JhoanLeon/Proyecto-MAFE/circuitos/sensores 1.jpg

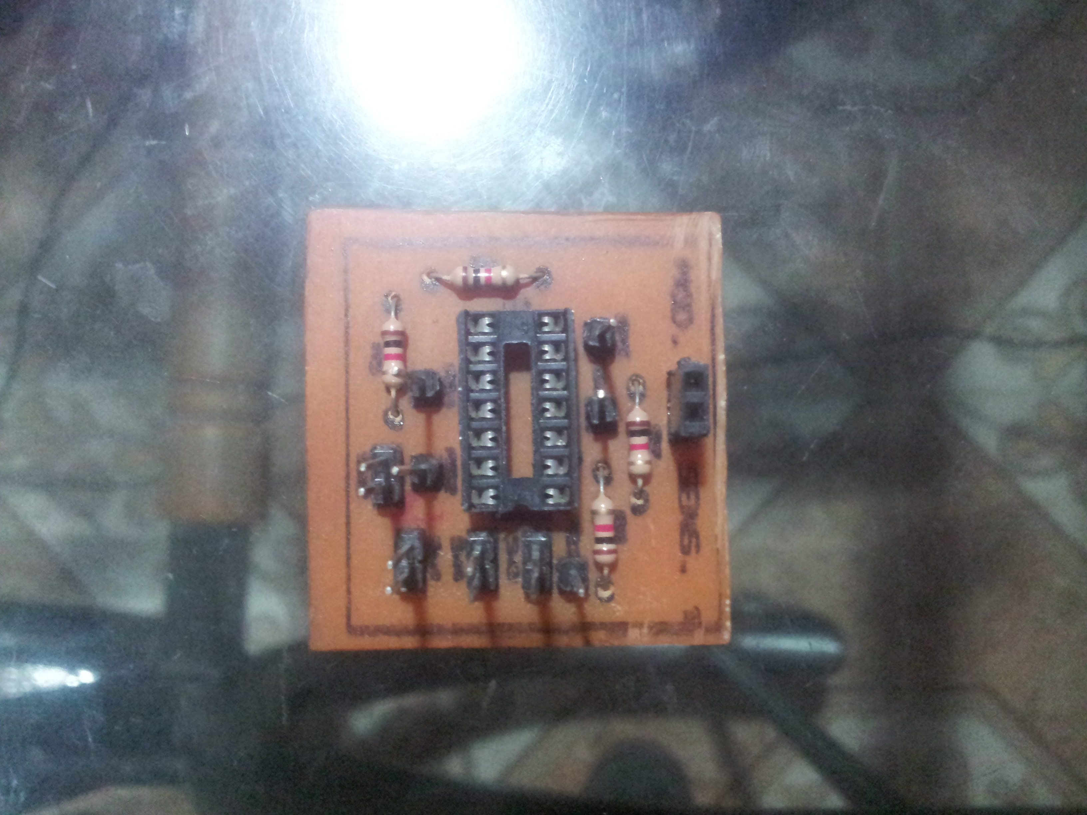
circuitos/sensores 1.jpg
