JhoanLeon/Proyecto-MAFE/anexos/22879273_1474528549298804_1385105198_o.jpg

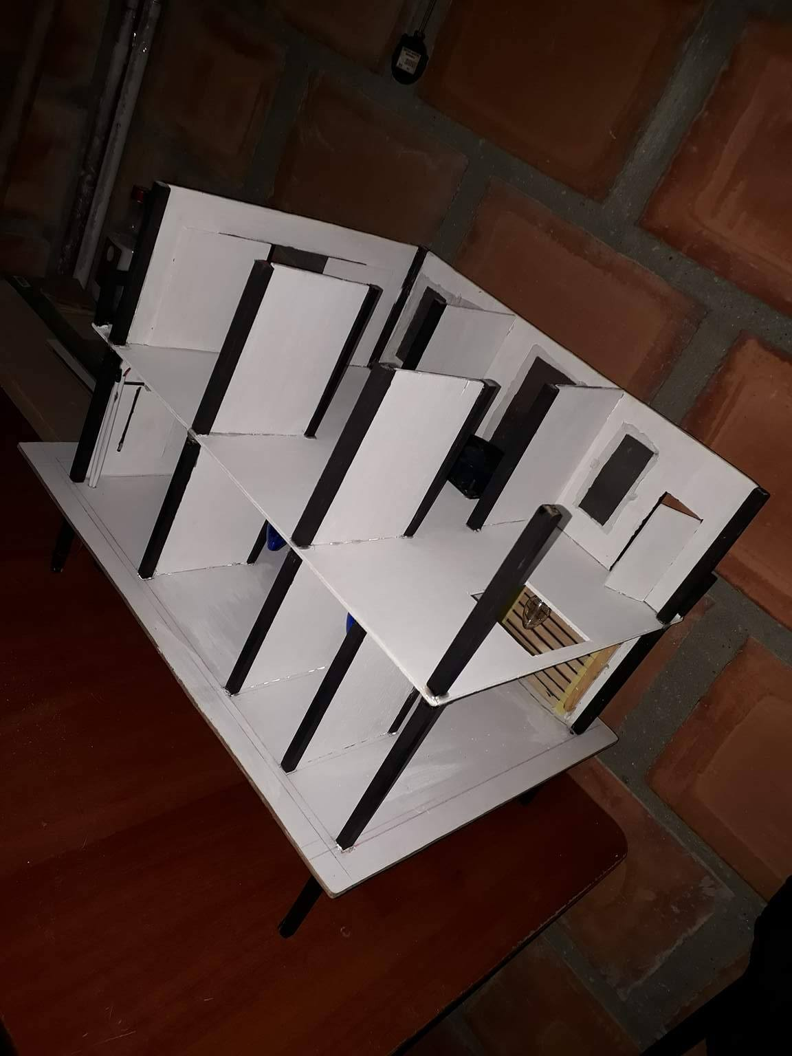
anexos/22879273_1474528549298804_1385105198_o.jpg
