JhoanLeon/Proyecto-MAFE/README.md

# Proyecto-MAFE
Proyecto de Automatización para casas convencionales basado en microcontroladores PIC y en comunicación inalámbrica bluetooth. Realizado en 2017 para obtener el título de bachiller técnico en electricidad y electrónica.

Diseño de esquemáticos y PCBs en el software PROTEUS 8 PROFESSIONAL. Programación de los microcontroladores PIC16F877A en lenguaje C utilizando el software PIC C COMPILER y el programador PICkit2.

Adicionalmente se presenta la documentación realizada del proyecto en la carpeta "Trabajo escrito".

Aquí se presenta una foto del sistema electrónico final, con los 5 módulos diseñados (main, potencia, sensores, motores y comunicación) junto a la fuente de alimentación.

22197838_1452732644811728_685561005_o

Y finalmente el montaje del sistema en la maqueta de presentación.

22882320_1474528212632171_1293554200_o
