JhoanLeon/Proyecto-MAFE/Trabajo escrito MAFE/Varios/Mentefacto proyecto.docx

Se encarga de controlar la parte mecánica del sistema

Se encarga de recibir y ejecutar todas las instrucciones del usuario

Conjunto de sistemas capaces de automatizar una vivienda, ofreciendo servicios de seguridad, gestión energética, bienestar y comunicaciones.

Controla todas las cargas de 120 VAC del proyecto

Módulo de potencia

Módulo de motores

Módulo de comunicación

Alimenta el módulo Bluetooth, la LCD, la sirena y las luces externas

Módulo de control

Módulo de sensores

Alimenta los interruptores magnéticos y la compuerta lógica AND

Modelo de automatización para casas convencionales, con un sistema compuesto por diferentes módulos electrónicos.

Sistema de control para una puerta convencional con fines de seguridad y comodidad

Puerta automática

Proyecto MAFE

Domótica

Compuesto por
