JhoanLeon/Proyecto-MAFE/Trabajo escrito MAFE/Varios/Mentefacto.docx

Electrónica

Digital

Analógica

Electricidad

Física

MAFE

Rama de la electrónica que trabaja con sistemas digitales y señales binarias que sólo toman valores de 1 o 0

Rama de la electrónica que trabaja con circuitos análogos y señales que pueden tomar valores infinitos

Grupo de fenómenos físicos conexos con el flujo y movimiento de electrones

Disciplina que aplica los fenómenos eléctricos originados por la conducción y el flujo de electrones en sistemas electrónicos.

Se clasifica en

Ciencia natural que se encarga del estudio de la energía, la materia, el tiempo y el espacio.
