JhoanLeon/Proyecto-MAFE/anexos/20170814_204834.jpg

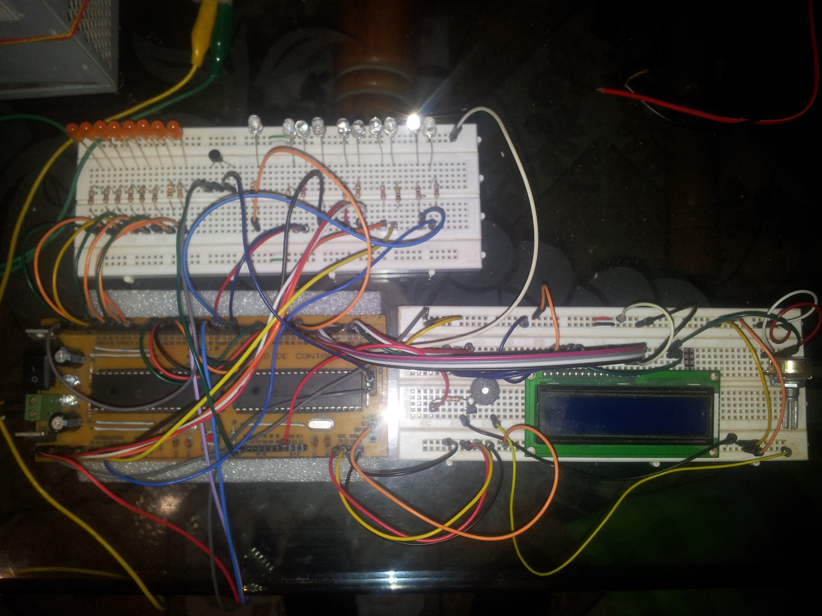
anexos/20170814_204834.jpg
