JhoanLeon/Proyecto-MAFE/anexos/20170814_223258.jpg

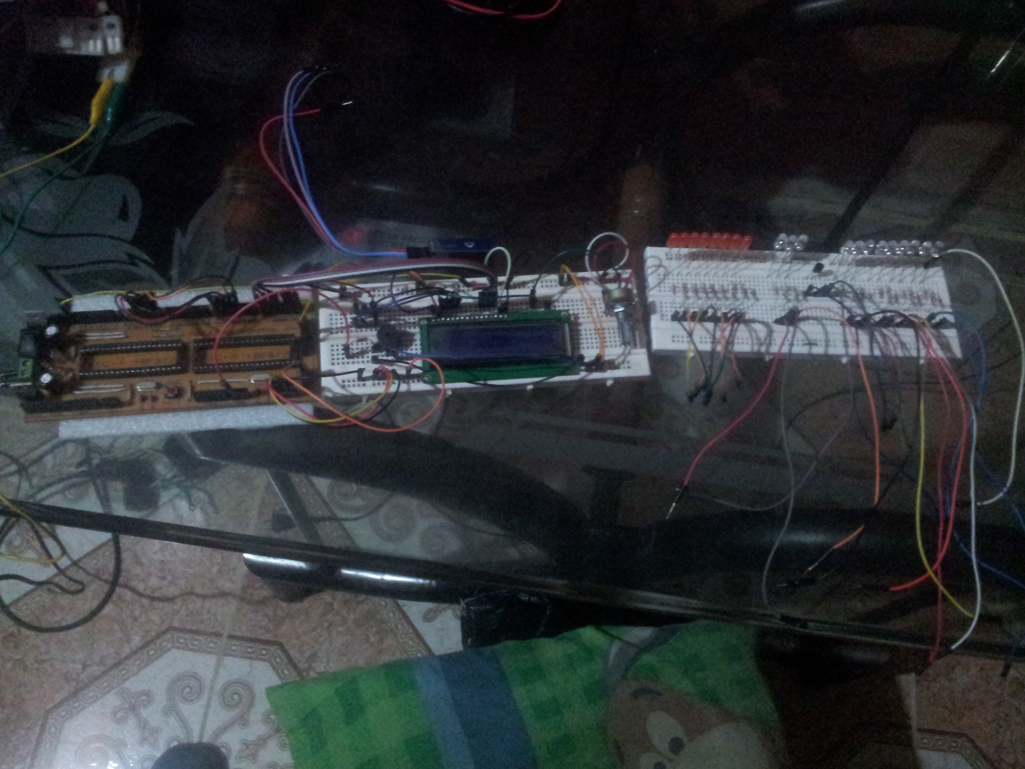
anexos/20170814_223258.jpg
