JhoanLeon/Proyecto-MAFE/anexos/20170830_212114-1.jpg

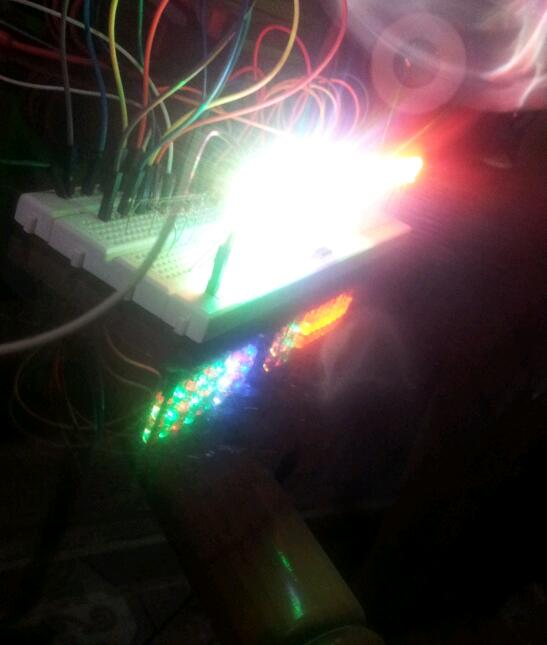
anexos/20170830_212114-1.jpg
