JhoanLeon/Proyecto-MAFE/anexos/20170902_212027.jpg

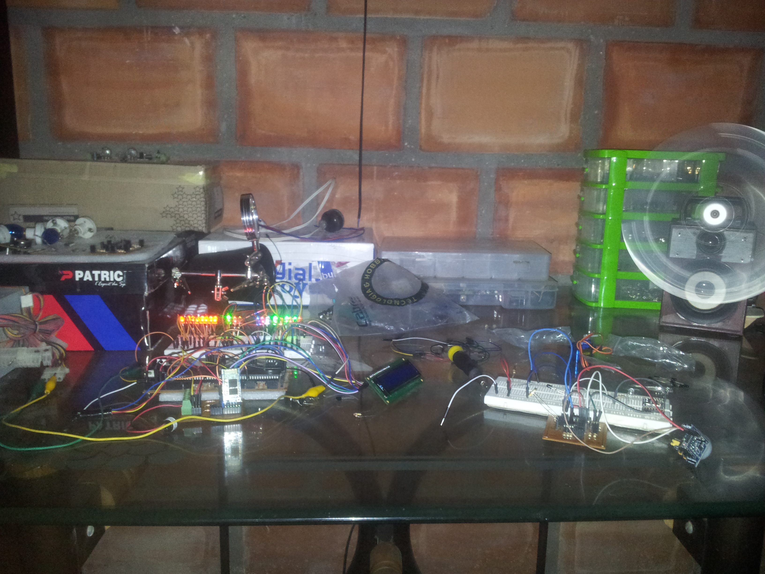
anexos/20170902_212027.jpg
