JhoanLeon/Proyecto-MAFE/anexos/20170904_183217.jpg

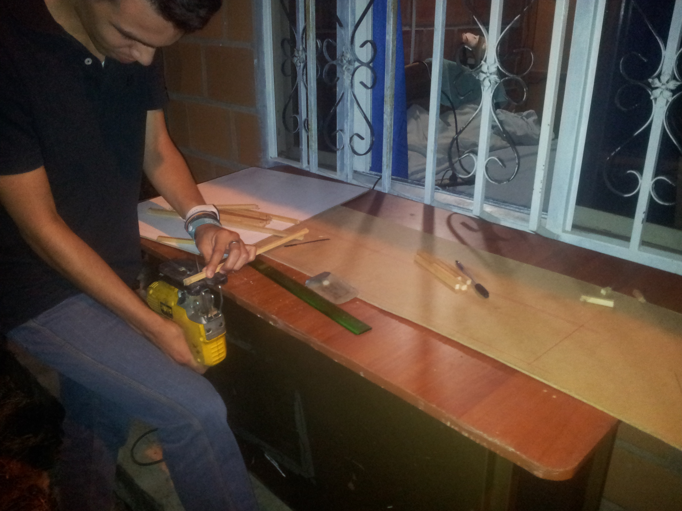
anexos/20170904_183217.jpg
