JhoanLeon/Proyecto-MAFE/anexos/20170904_184807-1.jpg

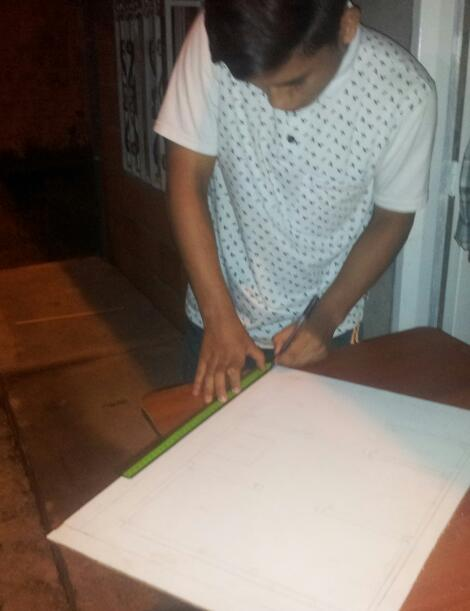
anexos/20170904_184807-1.jpg
