JhoanLeon/Proyecto-MAFE/anexos/20170905_202919.jpg

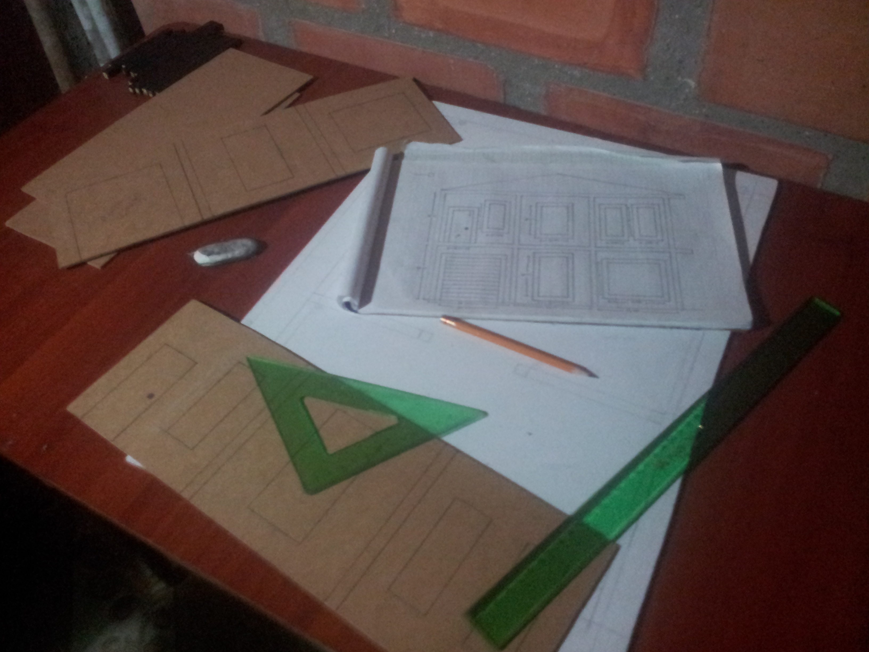
anexos/20170905_202919.jpg
