JhoanLeon/Proyecto-MAFE/anexos/20170905_223407.jpg

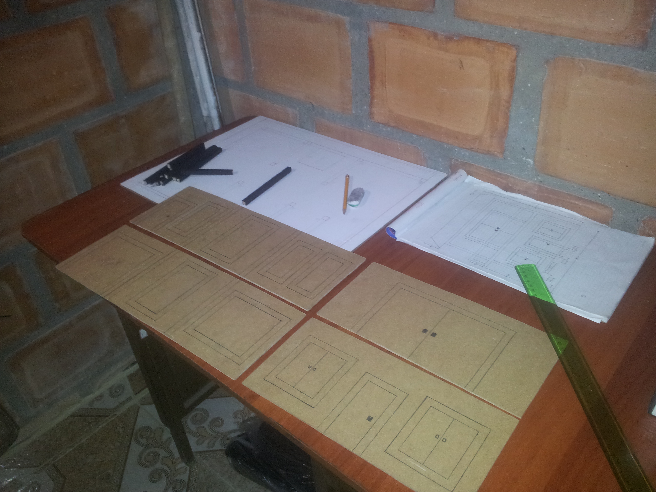
anexos/20170905_223407.jpg
