JhoanLeon/Proyecto-MAFE/anexos/20170907_213115.jpg

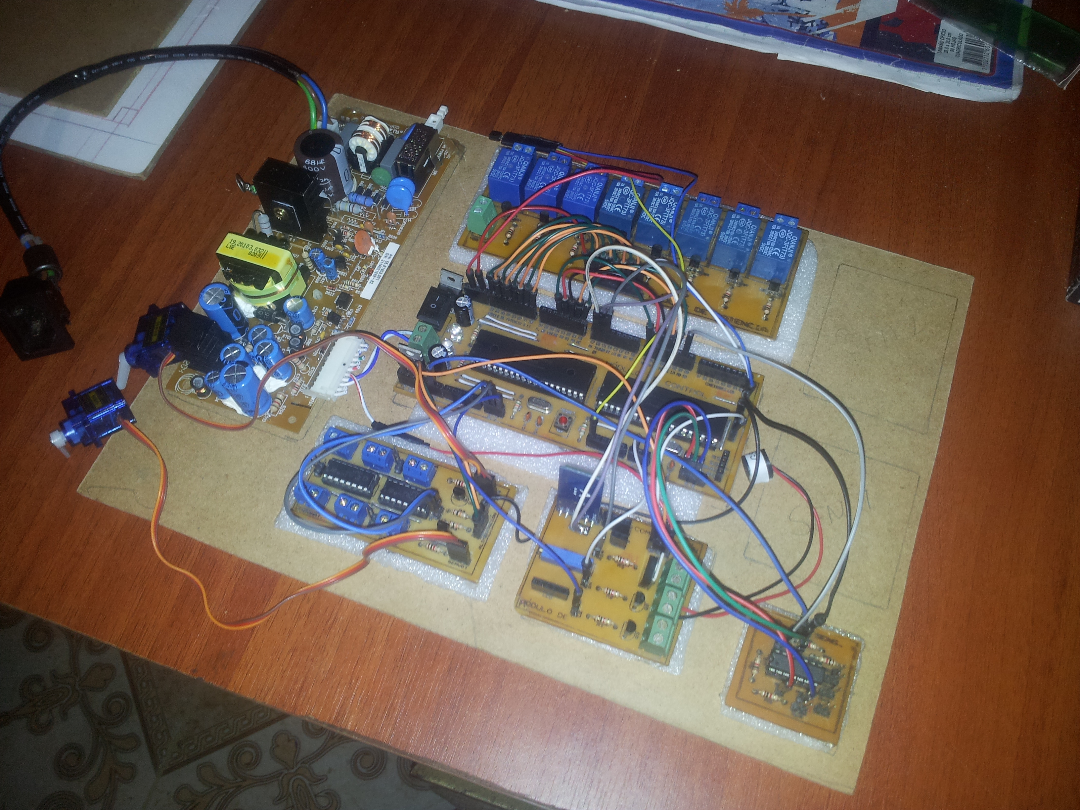
anexos/20170907_213115.jpg
