JhoanLeon/Proyecto-MAFE/anexos/20170911_104920.jpg

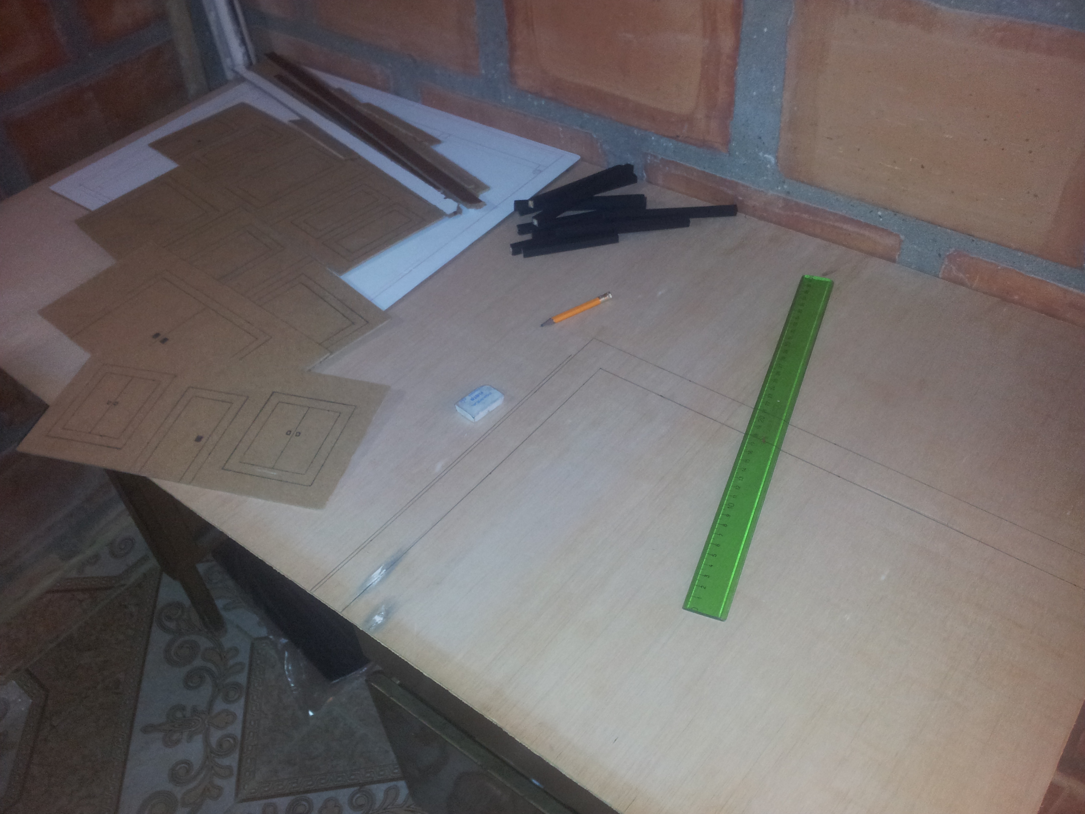
anexos/20170911_104920.jpg
