JhoanLeon/Proyecto-MAFE/anexos/20170913_202242.jpg

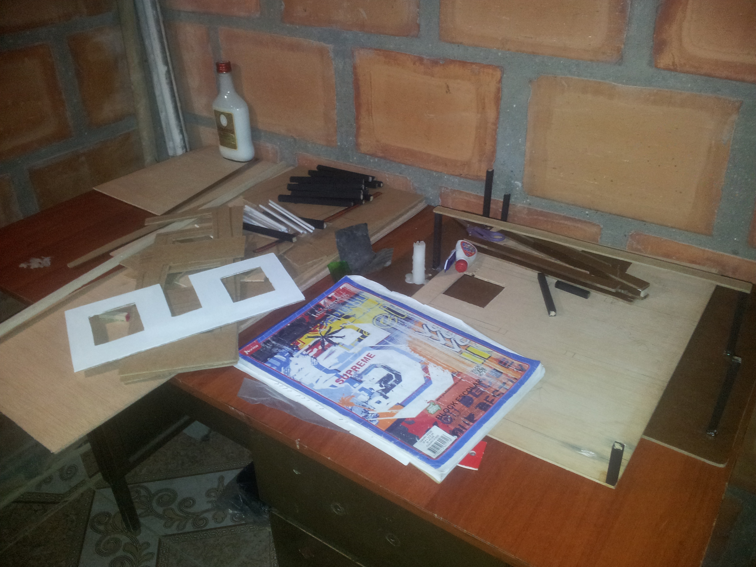
anexos/20170913_202242.jpg
