JhoanLeon/Proyecto-MAFE/anexos/20170914_204048.jpg

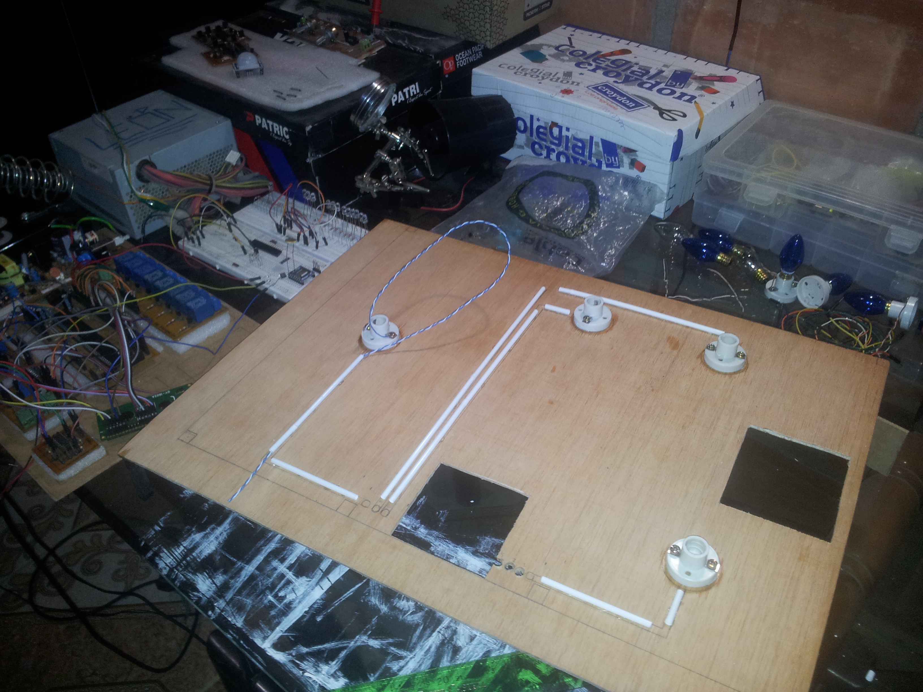
anexos/20170914_204048.jpg
