JhoanLeon/Proyecto-MAFE/anexos/20170914_222317.jpg

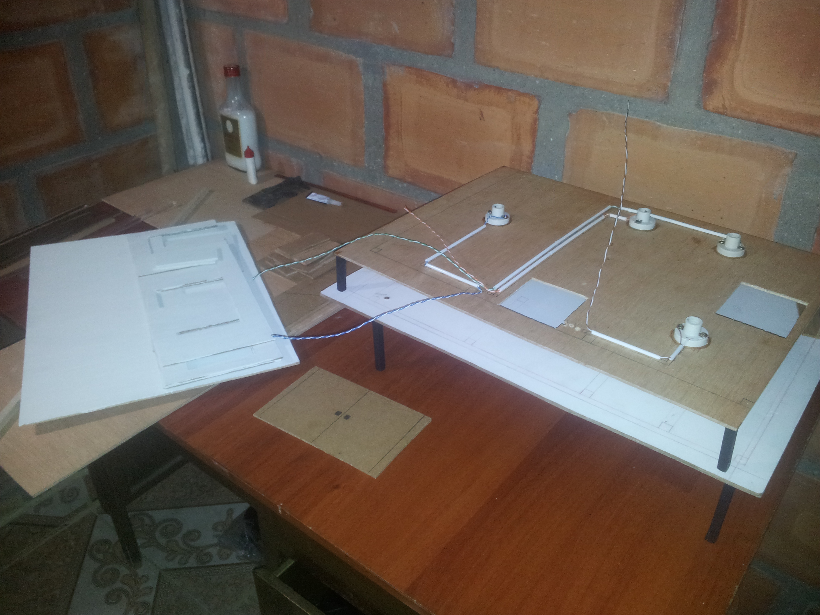
anexos/20170914_222317.jpg
