JhoanLeon/Proyecto-MAFE/circuitos/comunicación.jpg

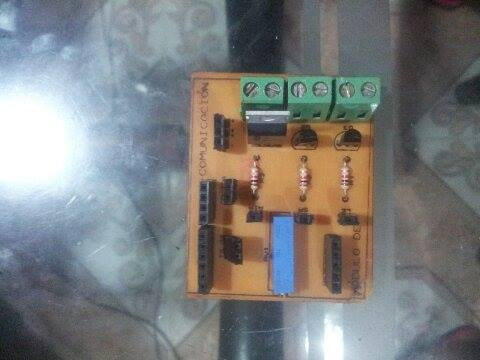
circuitos/comunicación.jpg
