JhoanLeon/Proyecto-MAFE/circuitos/control.jpg

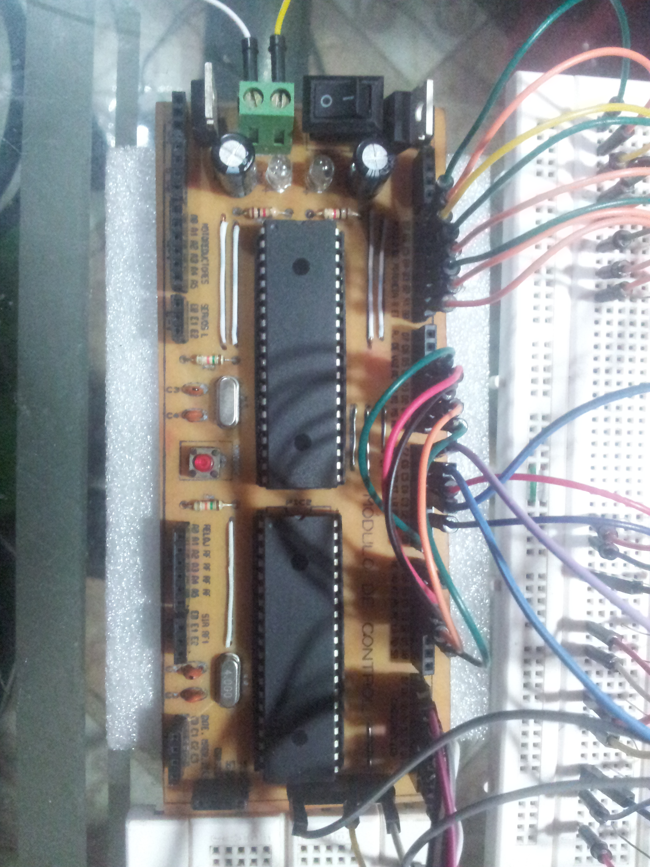
circuitos/control.jpg
