JhoanLeon/Proyecto-MAFE/circuitos/mod comunic isis.png

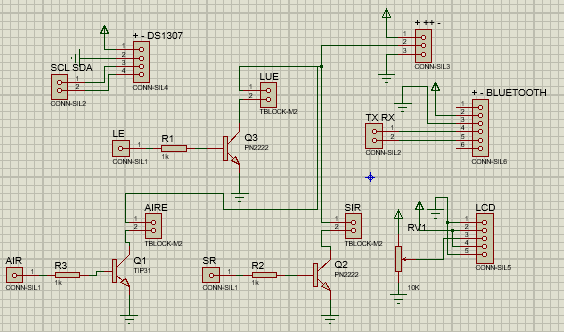
circuitos/mod comunic isis.png
