JhoanLeon/Proyecto-MAFE/circuitos/mod control isis.png

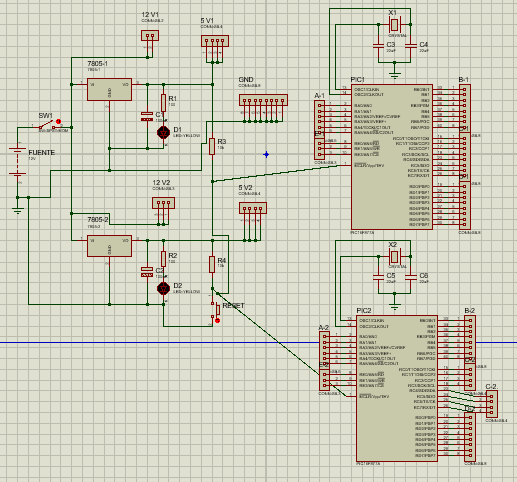
circuitos/mod control isis.png
