JhoanLeon/Proyecto-MAFE/circuitos/mod motor isis.png

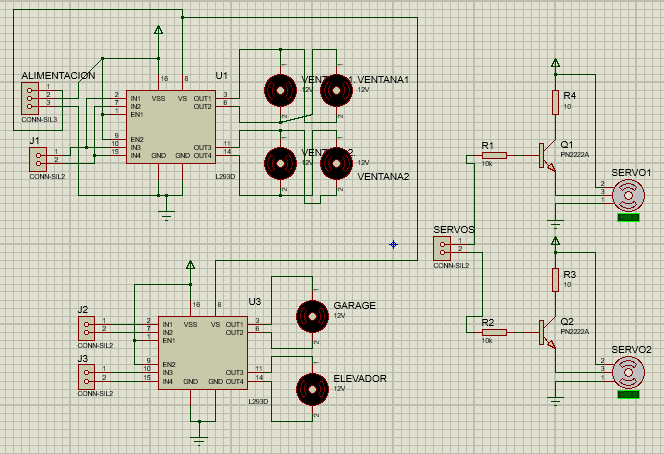
circuitos/mod motor isis.png
