JhoanLeon/Proyecto-MAFE/circuitos/mod poten isis.png

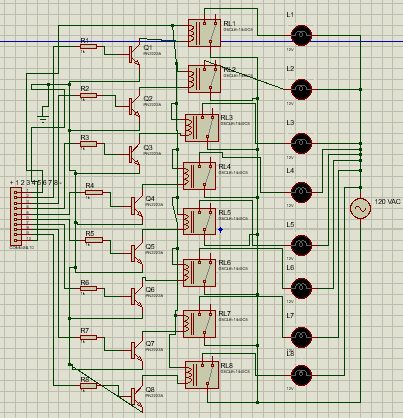
circuitos/mod poten isis.png
