JhoanLeon/Proyecto-MAFE/circuitos/mod sens 0 are.png

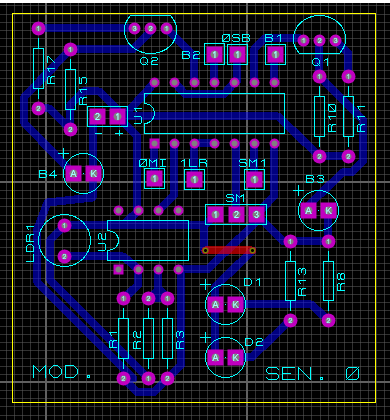
circuitos/mod sens 0 are.png
