JhoanLeon/Proyecto-MAFE/circuitos/mod sens 0 isis.png

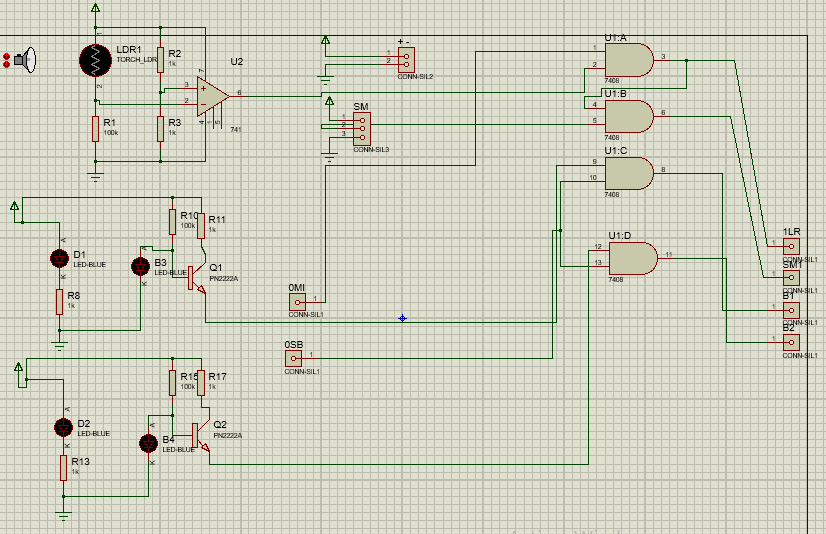
circuitos/mod sens 0 isis.png
