JhoanLeon/Proyecto-MAFE/circuitos/mod sens 1 are.png

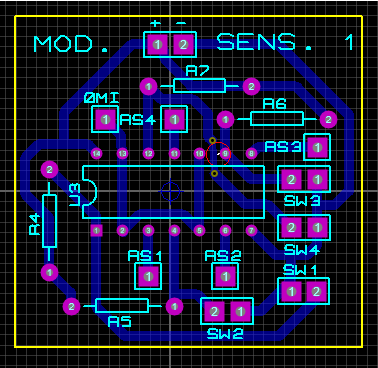
circuitos/mod sens 1 are.png
