JhoanLeon/Proyecto-MAFE/circuitos/mod sens 1 isis.png

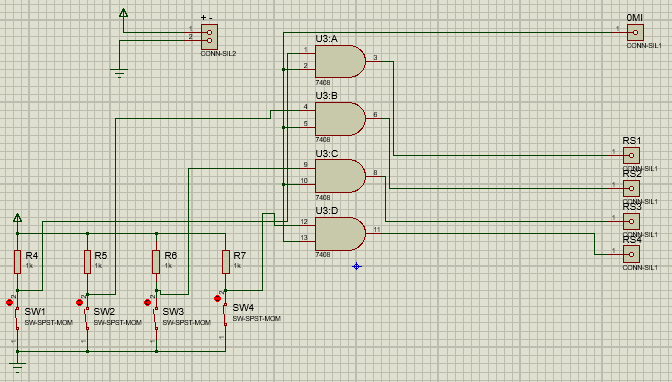
circuitos/mod sens 1 isis.png
