JhoanLeon/Proyecto-MAFE/circuitos/mod sens 2 isis.png

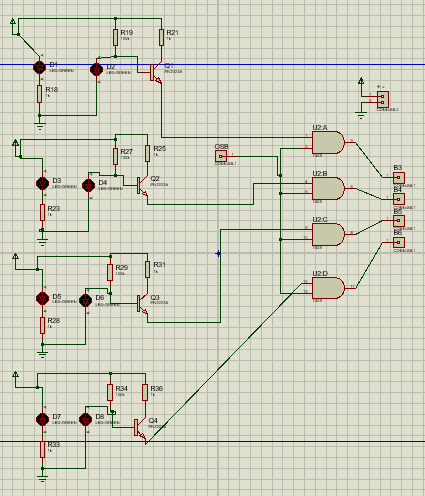
circuitos/mod sens 2 isis.png
