JhoanLeon/Proyecto-MAFE/circuitos/motores.jpg

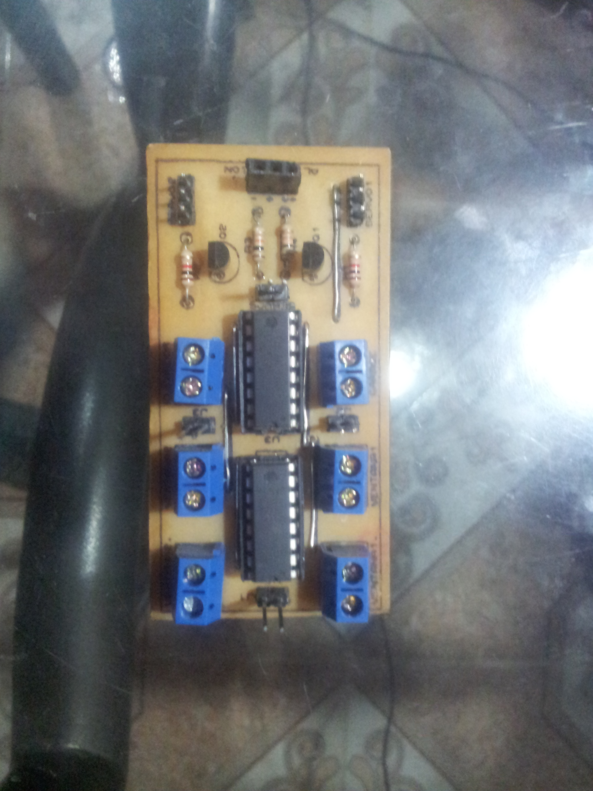
circuitos/motores.jpg
