JhoanLeon/Proyecto-MAFE/circuitos/potencia.jpg

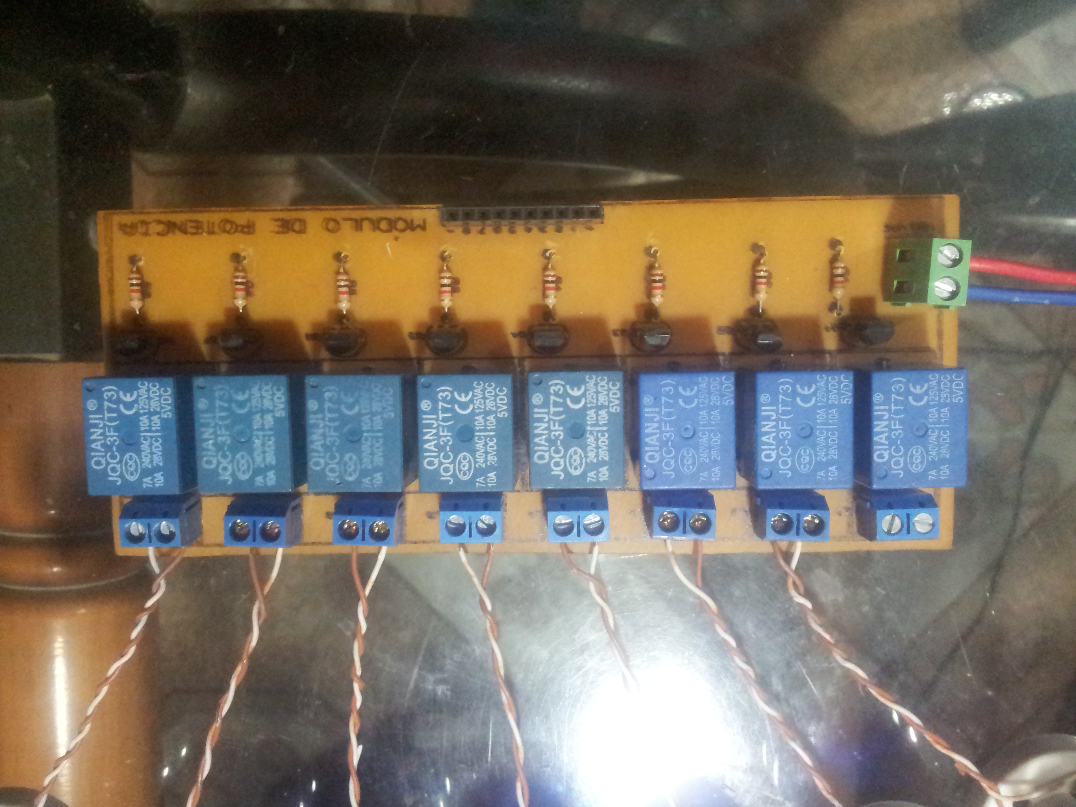
circuitos/potencia.jpg
