JhoanLeon/Proyecto-MAFE/circuitos/sensores 0.jpg

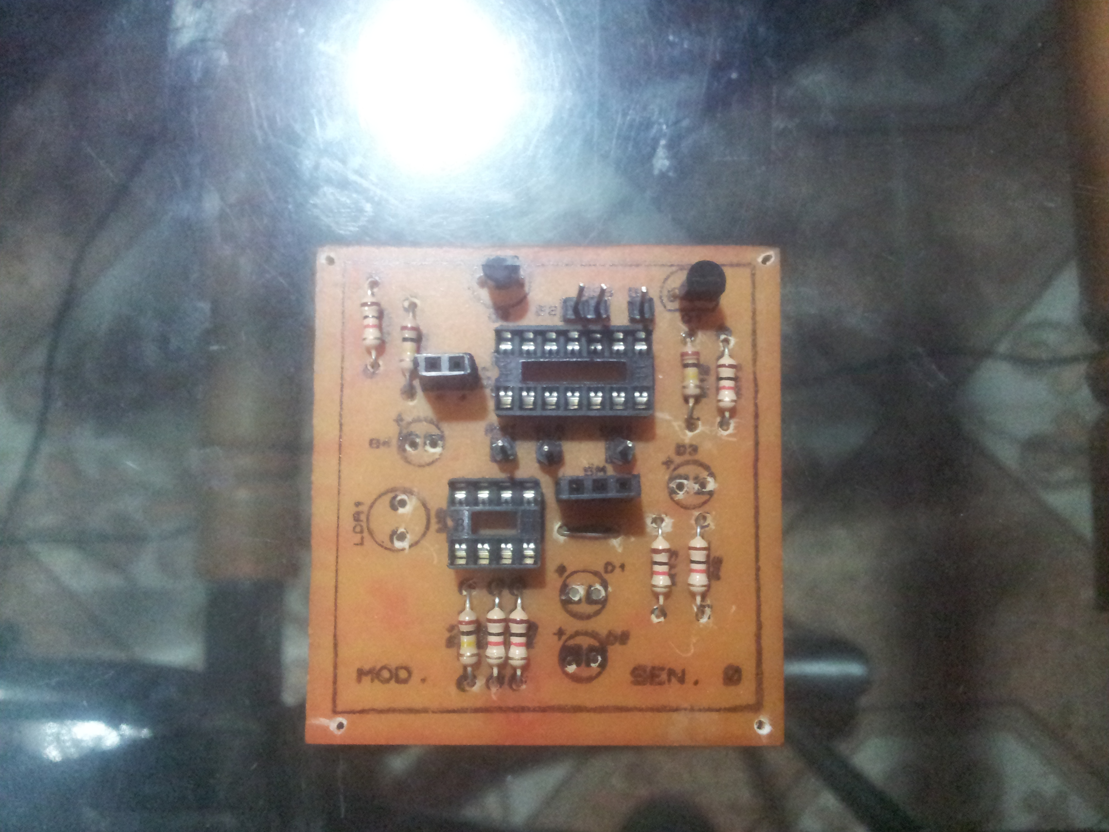
circuitos/sensores 0.jpg
