JhoanLeon/Proyecto-MAFE/circuitos/sensores 2.jpg

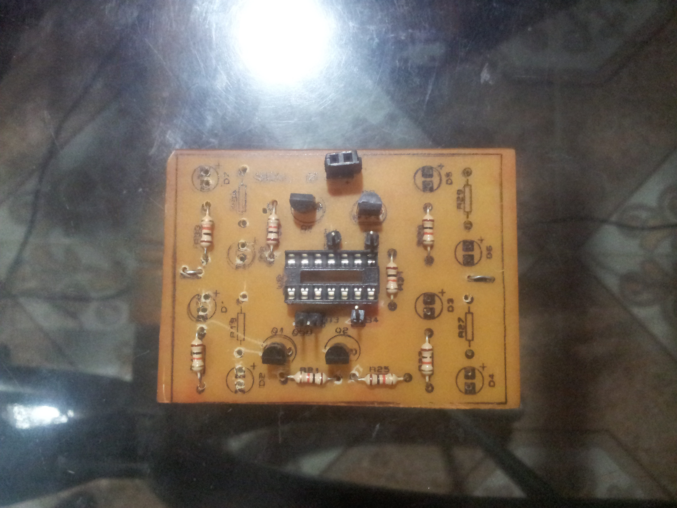
circuitos/sensores 2.jpg
