JhoanLeon/Proyecto-MAFE/Trabajo escrito MAFE/Varios/dommot_.jpg

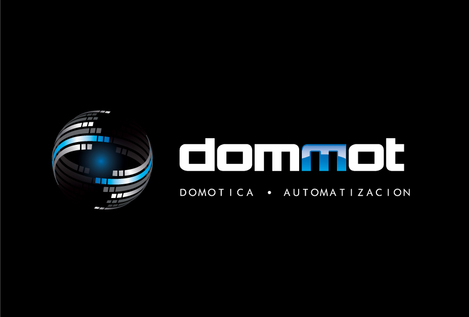
Trabajo escrito MAFE/Varios/dommot_.jpg
