JhoanLeon/Proyecto-MAFE/Trabajo escrito MAFE/Varios/domótica.jpg

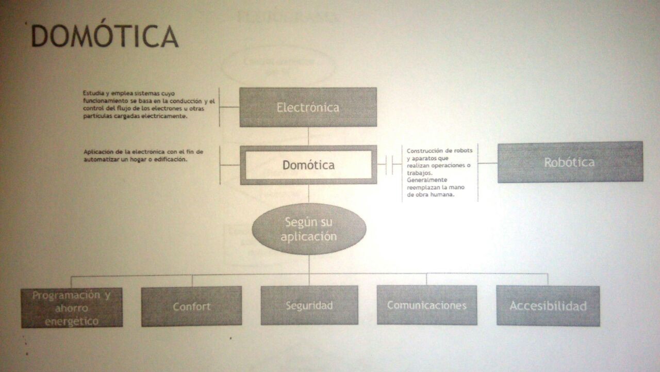
Trabajo escrito MAFE/Varios/domótica.jpg
