JhoanLeon/Proyecto-MAFE/Trabajo escrito MAFE/Varios/inicio.png

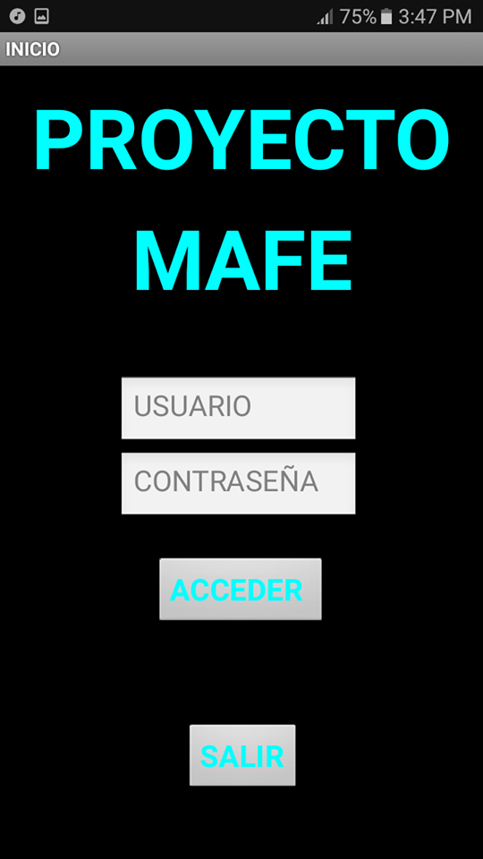
Trabajo escrito MAFE/Varios/inicio.png
