JhoanLeon/Proyecto-MAFE/Trabajo escrito MAFE/Varios/mentefacto proyec.png

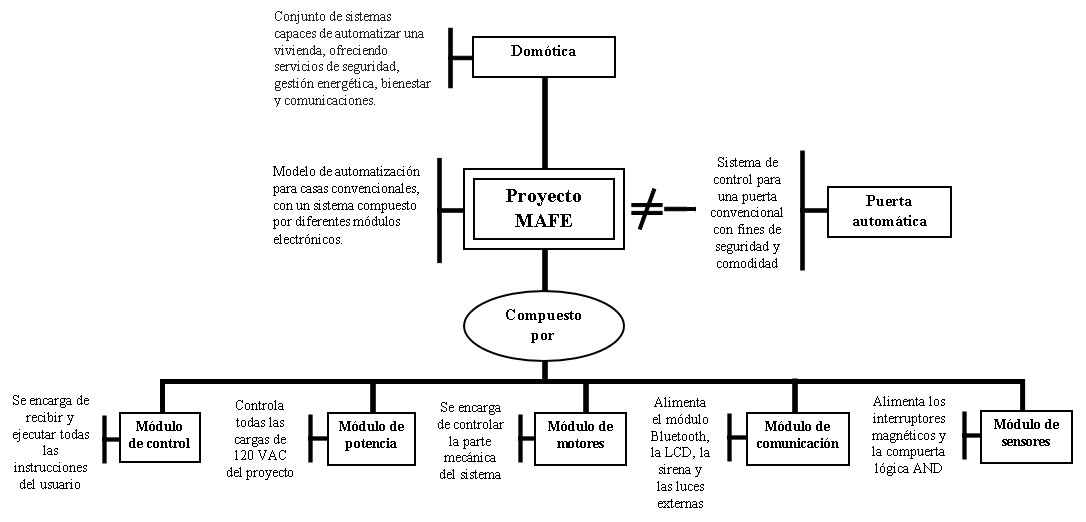
Trabajo escrito MAFE/Varios/mentefacto proyec.png
