JhoanLeon/Proyecto-MAFE/Trabajo escrito MAFE/Varios/menú.png

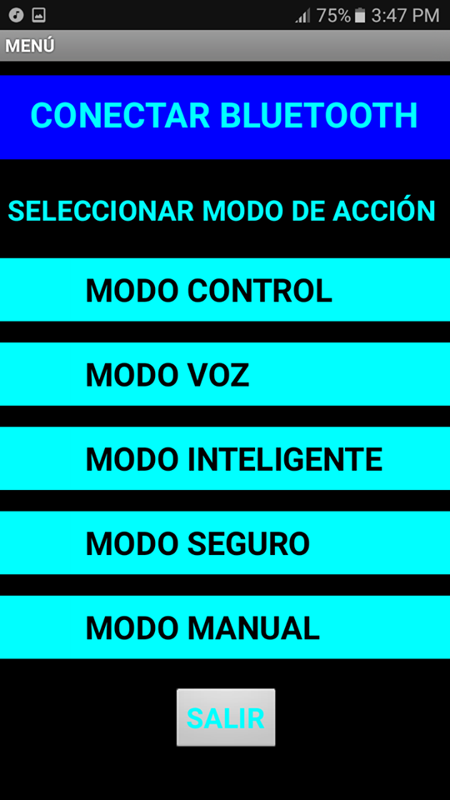
Trabajo escrito MAFE/Varios/menú.png
