JhoanLeon/Proyecto-MAFE/Trabajo escrito MAFE/Varios/modo control.png

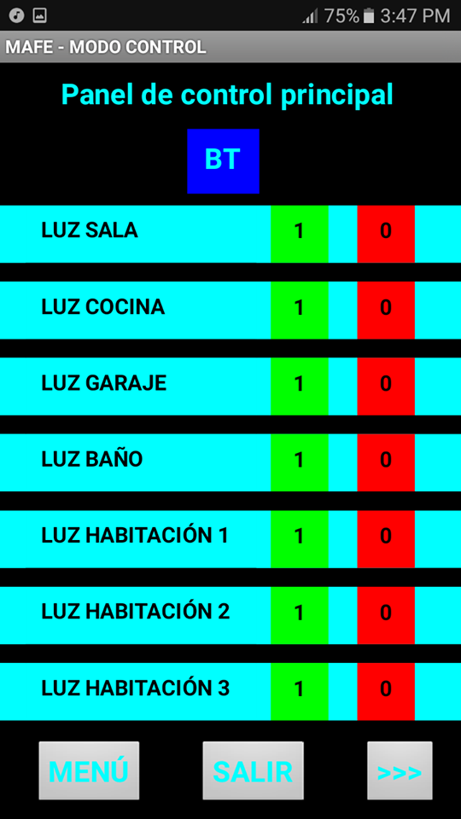
Trabajo escrito MAFE/Varios/modo control.png
