JhoanLeon/Proyecto-MAFE/Trabajo escrito MAFE/Varios/modo inteligente.png

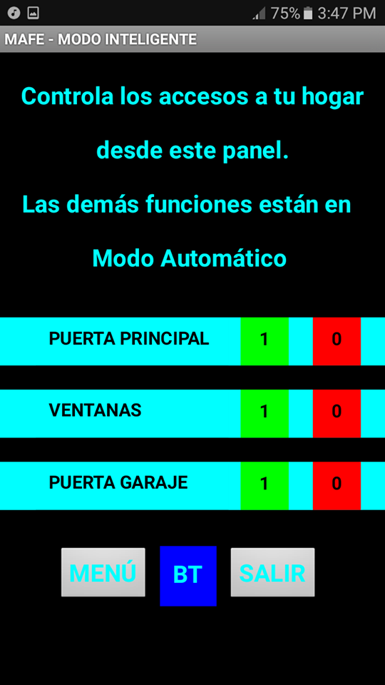
Trabajo escrito MAFE/Varios/modo inteligente.png
