JhoanLeon/Proyecto-MAFE/Trabajo escrito MAFE/Varios/modo seguro.png

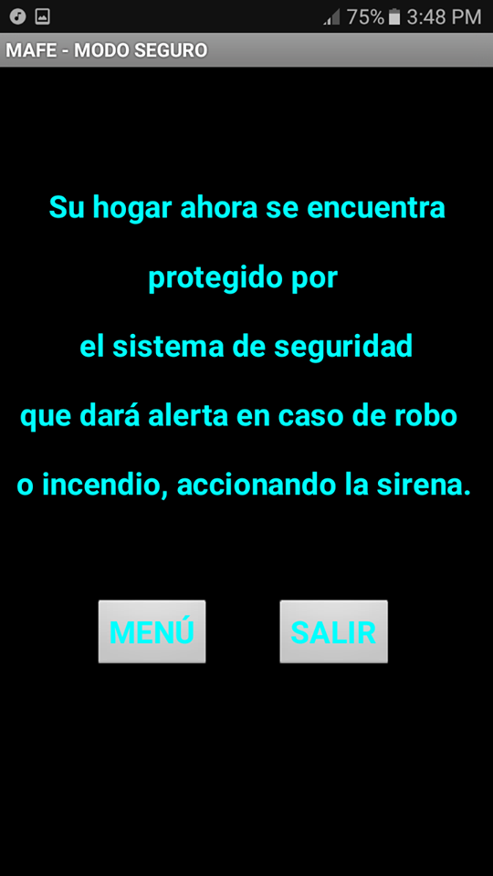
Trabajo escrito MAFE/Varios/modo seguro.png
