JhoanLeon/Proyecto-MAFE/Trabajo escrito MAFE/Varios/modo voz.png

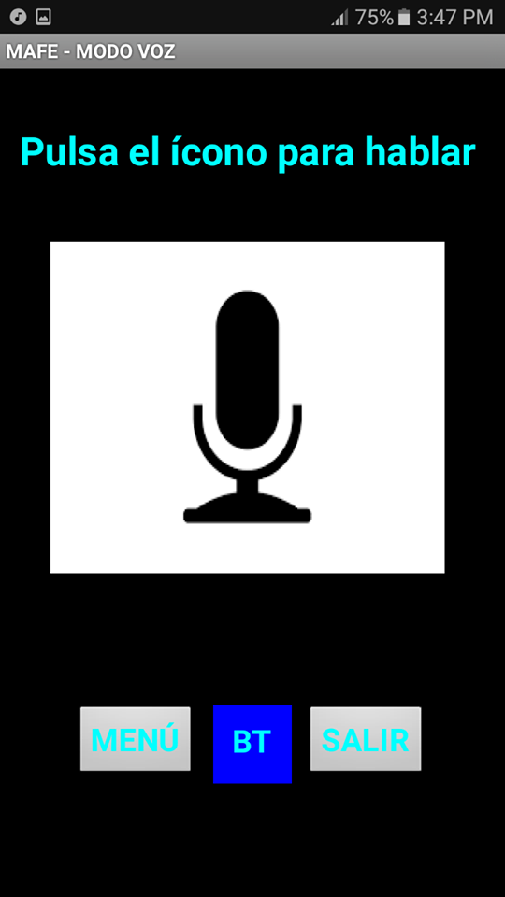
Trabajo escrito MAFE/Varios/modo voz.png
