JhoanLeon/Proyecto-MAFE/Trabajo escrito MAFE/Varios/ozom.jpg

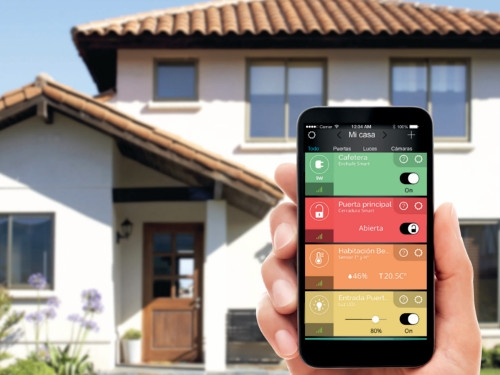
Trabajo escrito MAFE/Varios/ozom.jpg
