JhoanLeon/Proyecto-MAFE/Trabajo escrito MAFE/Varios/phone.png

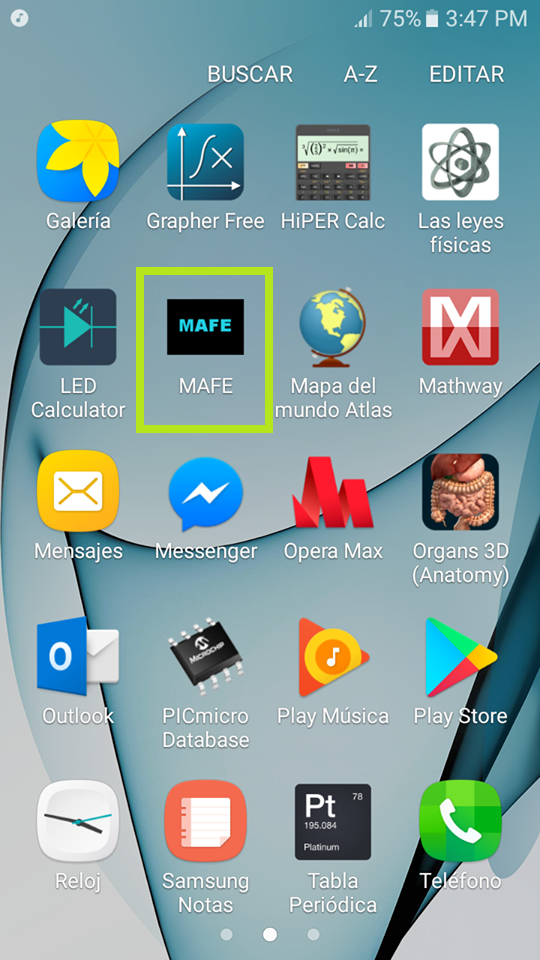
Trabajo escrito MAFE/Varios/phone.png
