JhoanLeon/Proyecto-MAFE/Trabajo escrito MAFE/Varios/modo manual.png

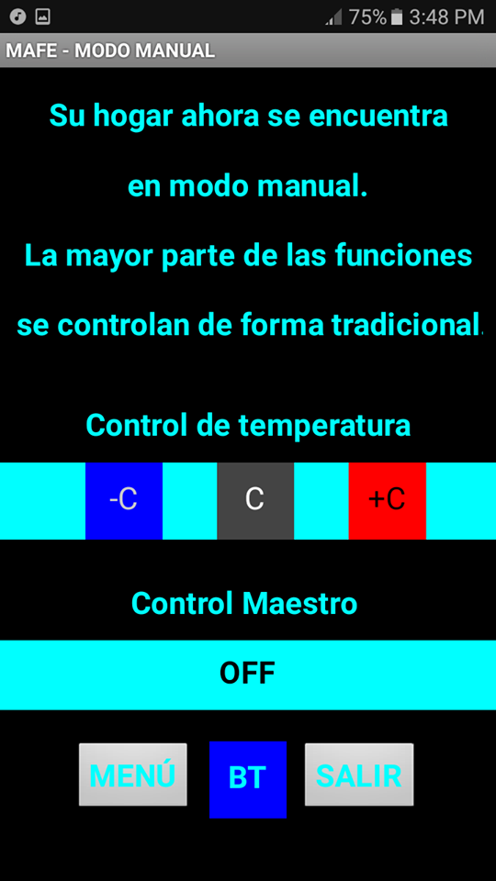
Trabajo escrito MAFE/Varios/modo manual.png
