JhoanLeon/Proyecto-MAFE/(list of files, drawings)

Other design files:
Circuitos Proteus MAFE/Módulo de comunicación.pdsprj
Circuitos Proteus MAFE/Módulo de control.pdsprj
Circuitos Proteus MAFE/Módulo de motores.pdsprj
Circuitos Proteus MAFE/Módulo de potencia.pdsprj
Circuitos Proteus MAFE/Módulo de sensores 1.pdsprj
Circuitos Proteus MAFE/Módulo de sensores 2.pdsprj
Circuitos Proteus MAFE/Módulo de sensores.pdsprj
Programación PICs MAFE/Programación PIC2 MAFE/SENSOR LM 35_LCD.DSN
Programación PICs MAFE/Programación PIC2 MAFE/SENSOR LM 35_LCD.pdsprj
